ocidburn/4-20-ma-to-pulse-output/hardware/am24_shield_bottom.png

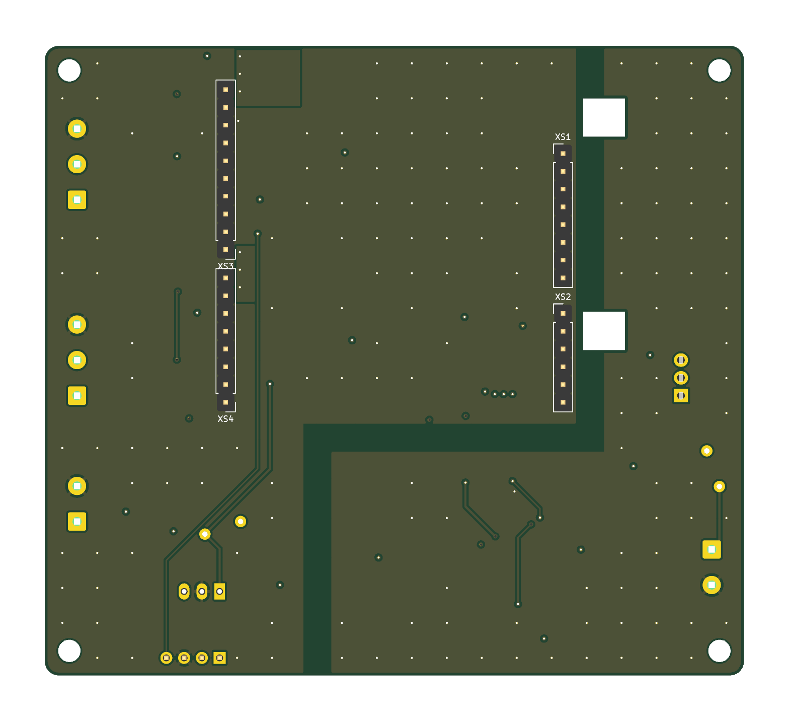
hardware/am24_shield_bottom.png
