ocidburn/4-20-ma-to-pulse-output/hardware/am24_shield_top.png

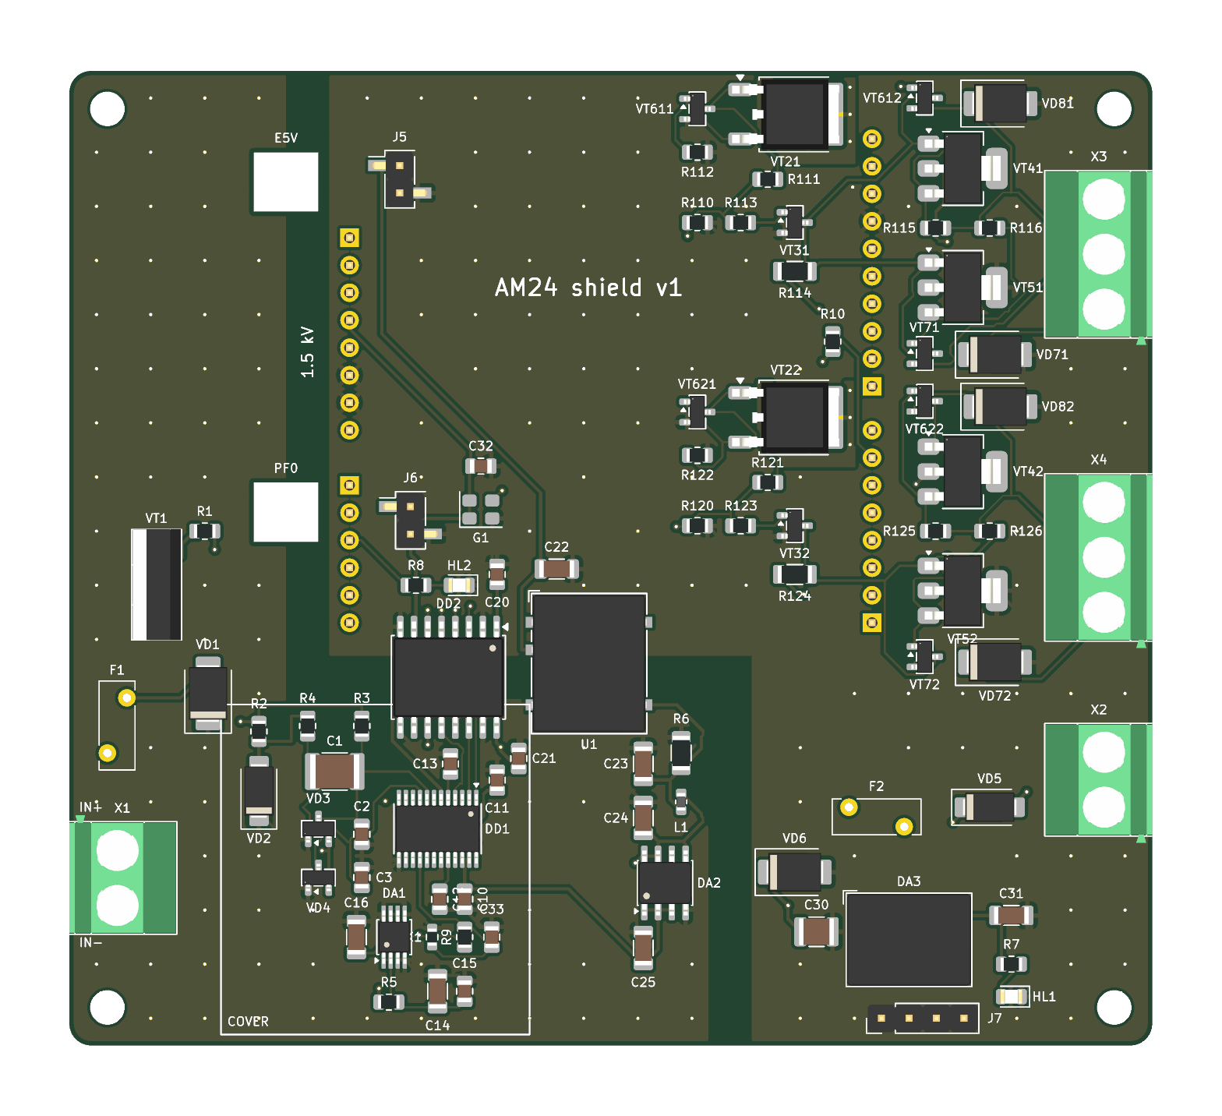
hardware/am24_shield_top.png
