ocidburn/4-20-ma-to-pulse-output/hardware/am24_shield_bom.csv

refs | qty | value | mpn | footprint
C1 | 1 | 0.47u 50V U2J | C1812C474J5JACTU | Capacitor_SMD:C_1812_4532Metric
C2 C3 | 2 | 10n C0G |  | Capacitor_SMD:C_0805_2012Metric
C10 C11 C12 C13 C15 C20 C21 C33 | 8 | 100n |  | Capacitor_SMD:C_0805_2012Metric
C14 C22 C24 C25 C31 | 5 | 10u 16V |  | Capacitor_SMD:C_1206_3216Metric
C16 | 1 | 10u 16V (2.7-100u req.) |  | Capacitor_SMD:C_1206_3216Metric
C23 | 1 | 4.7u 16V |  | Capacitor_SMD:C_1206_3216Metric
C30 | 1 | 10u 50V |  | Capacitor_SMD:C_1210_3225Metric
C32 | 1 | 10n |  | Capacitor_SMD:C_0805_2012Metric
DA1 | 1 | LTC6655BHMS8-3 | LTC6655BHMS8-3#PBF | Package_SO:MSOP-8_3x3mm_P0.65mm
DA2 | 1 | ADP7118ARDZ-3.3 | ADP7118ARDZ-3.3 | Package_SO:SOIC-8-1EP_3.9x4.9mm_P1.27mm_EP2.29x3mm
DA3 | 1 | R-78HB5.0-0.5 | R-78HB5.0-0.5 | Converter_DCDC:Converter_DCDC_RECOM_R-78HB-0.5_THT
DD1 | 1 | AD7124-4BRUZ | AD7124-4BRUZ | Package_SO:TSSOP-24_4.4x7.8mm_P0.65mm
DD2 | 1 | ISO7741DWR | ISO7741DWR | Package_SO:SOIC-16W_7.5x10.3mm_P1.27mm
F1 | 1 | MF-R005-0 50mA | MF-R005-0 | AM24:Fuse_Bourns_MF-R_8.0x3.1mm_P5.10mm
F2 | 1 | MF-R050 0.5A | MF-R050 | AM24:Fuse_Bourns_MF-R_8.0x3.1mm_P5.10mm
G1 | 1 | ASTX-H11-10.000MHZ-T | ASTX-H11-10.000MHZ-T | Oscillator:Oscillator_SMD_Abracon_ASE-4Pin_3.2x2.5mm
HL1 | 1 | LED green |  | LED_SMD:LED_0805_2012Metric
HL2 | 1 | LED red |  | LED_SMD:LED_0805_2012Metric
J5 | 1 | +5V -> E5V (CN7-6) |  | Connector_PinHeader_2.54mm:PinHeader_1x02_P2.54mm_Vertical_SMD_Pin1Left
J6 | 1 | TCXO -> OSC_IN (PF0) |  | Connector_PinHeader_2.54mm:PinHeader_1x02_P2.54mm_Vertical_SMD_Pin1Left
J7 | 1 | GPS PPS: +5V, +3V3, GND, PPS |  | Connector_PinHeader_2.54mm:PinHeader_1x04_P2.54mm_Vertical
L1 | 1 | BLM18KG601SN1D | BLM18KG601SN1D | Inductor_SMD:L_0603_1608Metric
R1 | 1 | 22R (select 15-33R) |  | Resistor_SMD:R_0805_2012Metric
R2 | 1 | 50R Z-foil 0.05% | Y402250R0000A9R | Resistor_SMD:R_0805_2012Metric
R3 R4 | 2 | 1k 0.1% 25ppm | ERA-6AEB102V | Resistor_SMD:R_0805_2012Metric
R6 | 1 | 270R 0.25W ballast |  | Resistor_SMD:R_1206_3216Metric
R8 | 1 | 330R |  | Resistor_SMD:R_0805_2012Metric
R9 | 1 | 10k 0.1% 25ppm | ERA-6AEB103V | Resistor_SMD:R_0805_2012Metric
R10 | 1 | 100R |  | Resistor_SMD:R_0805_2012Metric
R110 R120 | 2 | 10k |  | Resistor_SMD:R_0805_2012Metric
R111 R113 R121 R123 R7 | 5 | 1k |  | Resistor_SMD:R_0805_2012Metric
R112 R115 R116 R122 R125 R126 R5 | 7 | 10R |  | Resistor_SMD:R_0805_2012Metric
R114 R124 | 2 | 4k7 0.25W |  | Resistor_SMD:R_1206_3216Metric
RK1 | 1 | NTC 10k 1% B25/50 3380K | NCU18XH103F60RB | Resistor_SMD:R_0603_1608Metric
U1 | 1 | NXE1S0505MC-R7 | NXE1S0505MC-R7 | Converter_DCDC:Converter_DCDC_Murata_NXExSxxxxMC_SMD
VD1 | 1 | SMBJ33CA | SMBJ33CA-13-F | Diode_SMD:D_SMB
VD2 | 1 | S1M | S1M | Diode_SMD:D_SMA
VD3 VD4 | 2 | BAV199 | BAV199,215 | Package_TO_SOT_SMD:SOT-23
VD5 | 1 | SS110 | SS110 | Diode_SMD:D_SMA
VD6 VD71 VD72 VD81 VD82 | 5 | SMBJ33A | SMBJ33ATR | Diode_SMD:D_SMB
VT1 | 1 | DN2540N5-G | DN2540N5-G | Package_TO_SOT_THT:TO-220-3_Vertical
VT21 VT22 | 2 | NTD3055L104T4G | NTD3055L104T4G | Package_TO_SOT_SMD:TO-252-2
VT31 VT32 VT611 VT612 VT621 VT622 | 6 | BC847B | BC847B,215 | Package_TO_SOT_SMD:SOT-23
VT41 VT42 | 2 | BCP56-16 | BCP56-16T1G | Package_TO_SOT_SMD:SOT-223-3_TabPin2
VT51 VT52 | 2 | BCP53-16 | BCP5316QTA | Package_TO_SOT_SMD:SOT-223-3_TabPin2
VT71 VT72 | 2 | BC857B | BC857B,215 | Package_TO_SOT_SMD:SOT-23
X1 | 1 | IN 4-20 mA |  | TerminalBlock_Phoenix:TerminalBlock_Phoenix_MKDS-1,5-2-5.08_1x02_P5.08mm_Horizontal
X2 | 1 | 24V DC |  | TerminalBlock_Phoenix:TerminalBlock_Phoenix_MKDS-1,5-2-5.08_1x02_P5.08mm_Horizontal
X3 | 1 | OUT1 PP/OC/0V |  | TerminalBlock_Phoenix:TerminalBlock_Phoenix_MKDS-1,5-3-5.08_1x03_P5.08mm_Horizontal
X4 | 1 | OUT2 PP/OC/0V |  | TerminalBlock_Phoenix:TerminalBlock_Phoenix_MKDS-1,5-3-5.08_1x03_P5.08mm_Horizontal
XS1 | 1 | Arduino POWER |  | Connector_PinHeader_2.54mm:PinHeader_1x08_P2.54mm_Vertical
XS2 | 1 | Arduino A0-A5 |  | Connector_PinHeader_2.54mm:PinHeader_1x06_P2.54mm_Vertical
XS3 | 1 | Arduino D8-D15 |  | Connector_PinHeader_2.54mm:PinHeader_1x10_P2.54mm_Vertical
XS4 | 1 | Arduino D0-D7 |  | Connector_PinHeader_2.54mm:PinHeader_1x08_P2.54mm_Vertical
