ocidburn/4-20-ma-to-pulse-output/hardware/am24_shield.pdf

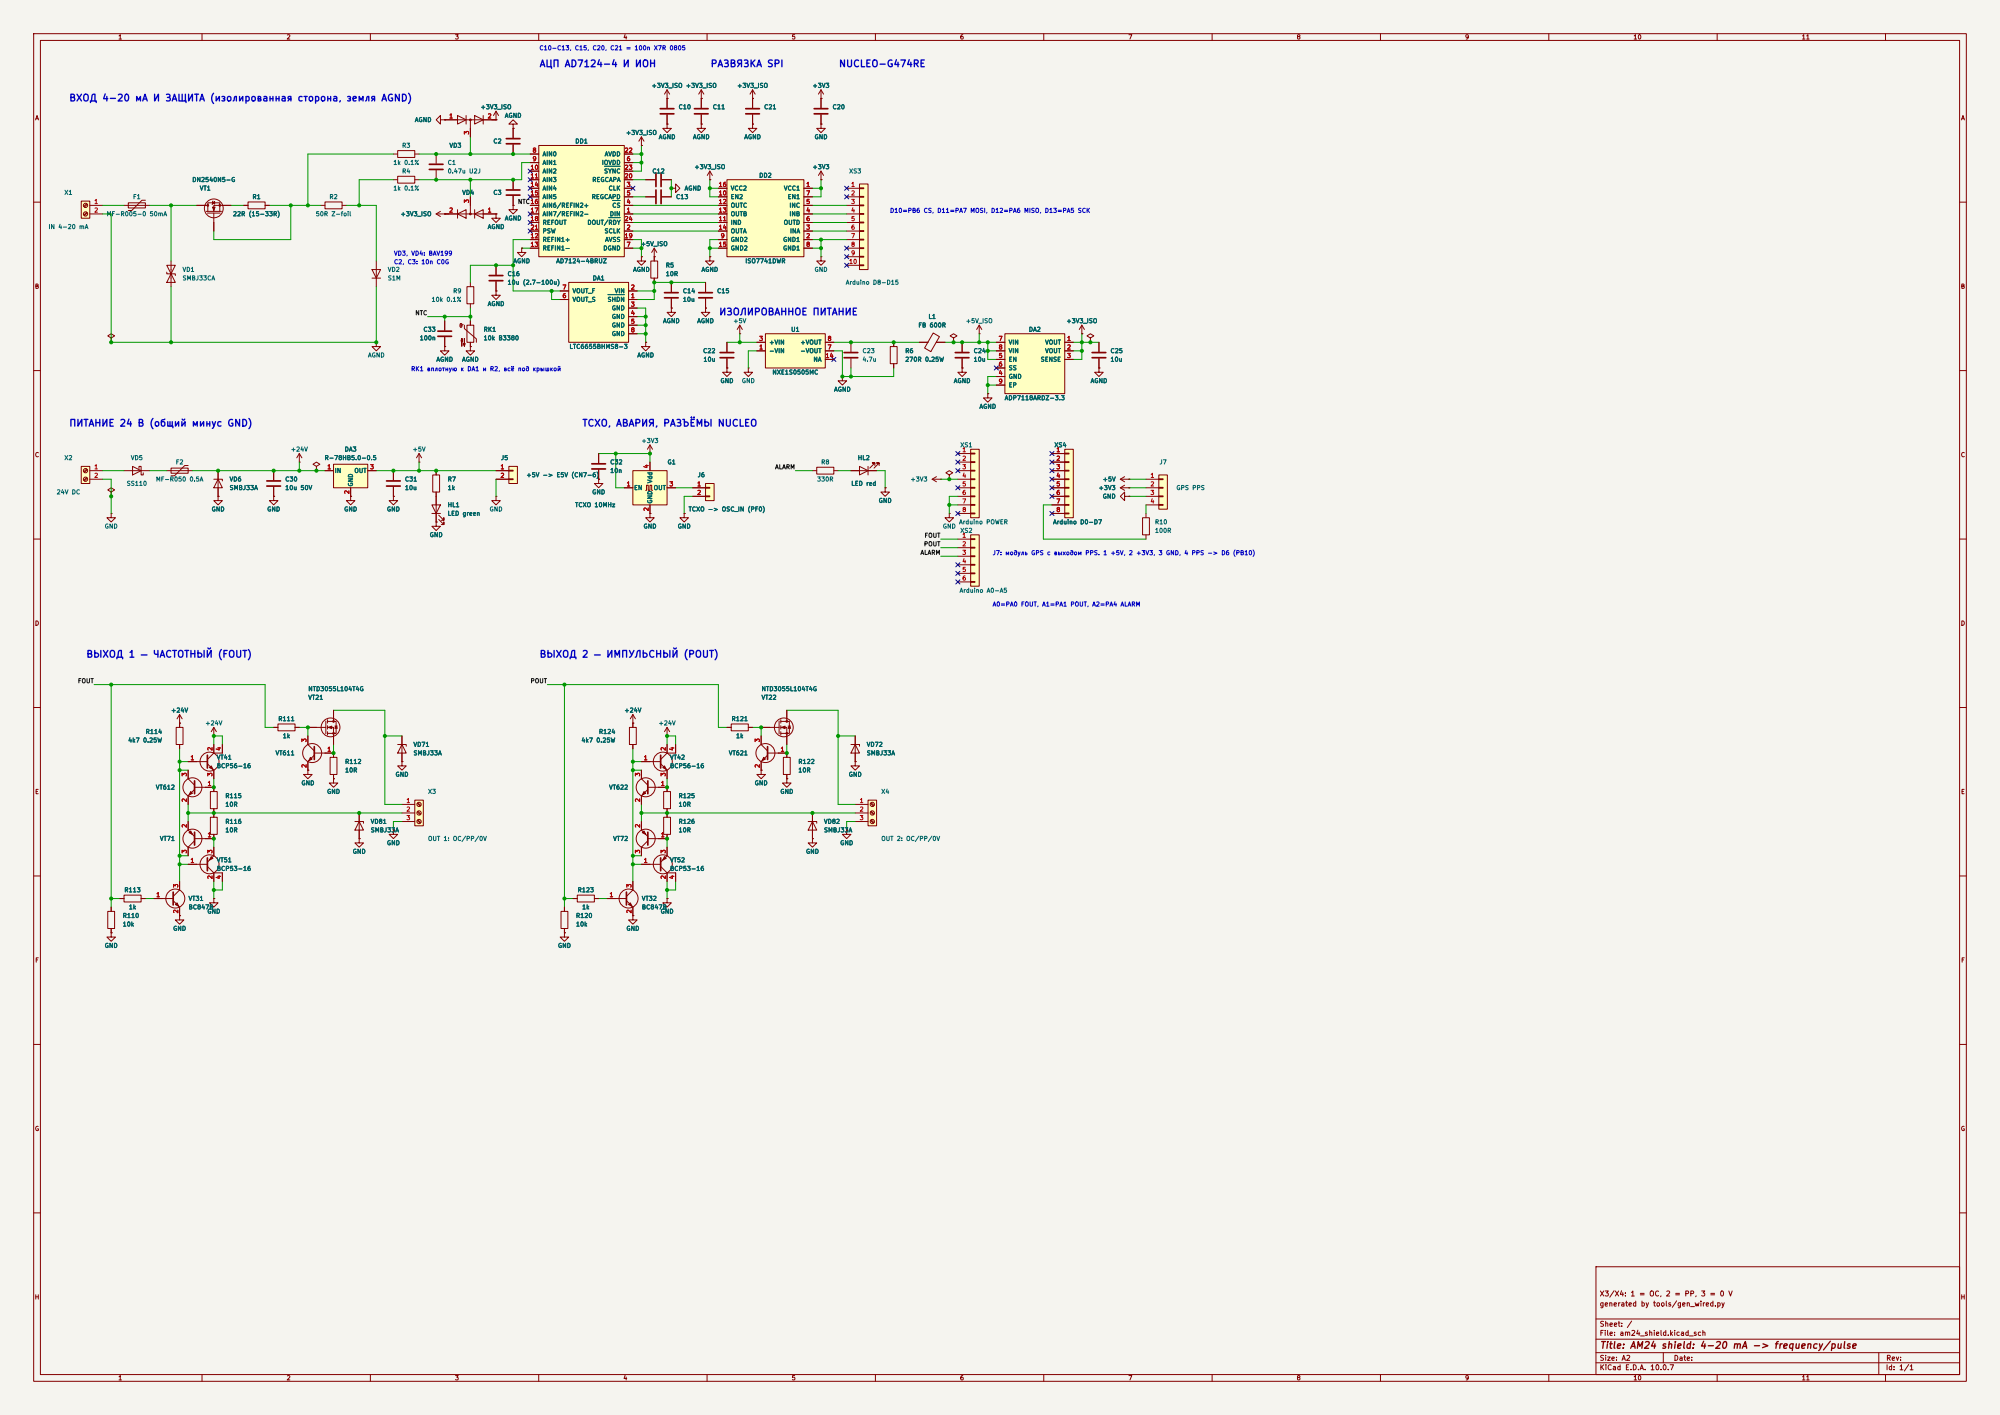
[picture p5: page 1]

ВХОД 4-20 мА И ЗАЩИТА (изолированная сторона, земля AGND)

AIN1 9

C2, C3: 10n C0G ПИТАНИЕ 24 В (общий минус GND)

J7: модуль GPS с выходом PPS. 1 +5V, 2 +3V3, 3 GND, 4 PPS -> D6 (PB10) RK1 вплотную к DA1 и R2, всё под крышкой

TCXO, АВАРИЯ, РАЗЪЁМЫ NUCLEO

generated by tools/gen_wired.py

Sheet: /
File: am24_shield.kicad_sch
Title: AM24 shield: 4-20 mA -> frequency/pulse

Size: A2 | Rev:
KiCad E.D.A. 10.0.7 | Id: 1/1
