ocidburn/4-20-ma-to-pulse-output/hardware/am24_shield_assembly_top.pdf

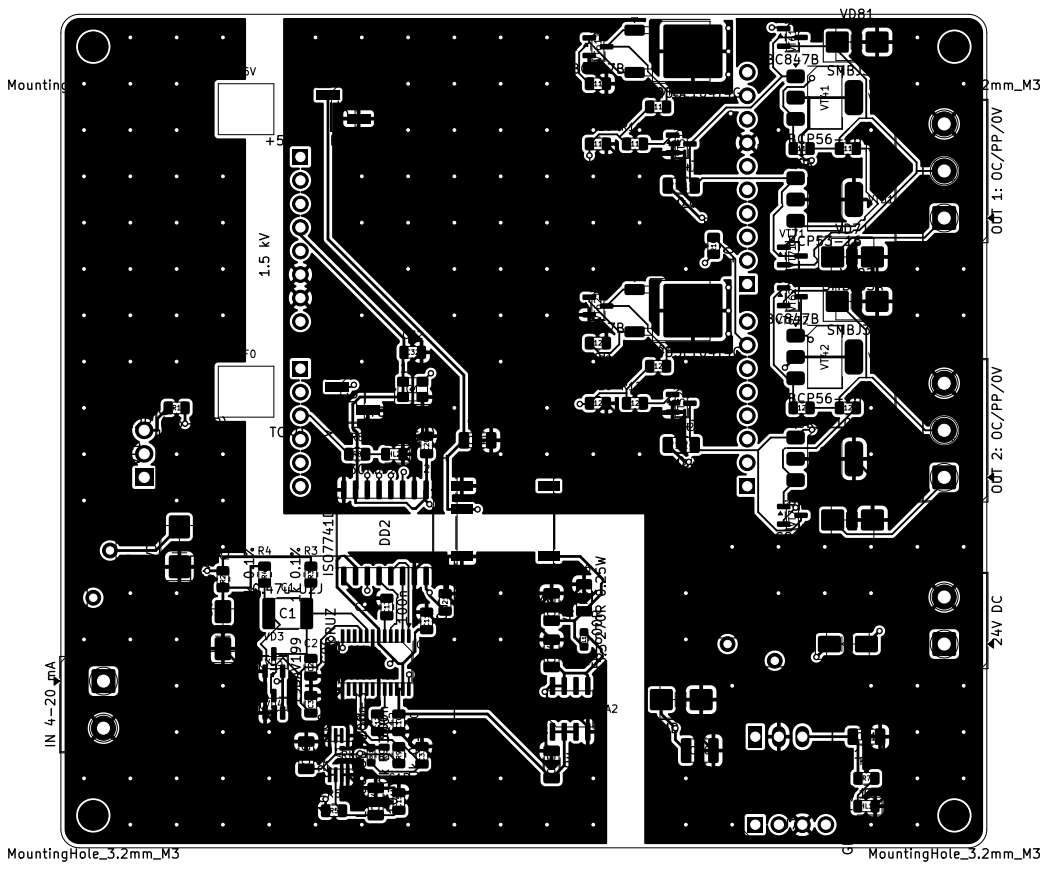
[picture p6: page 1]
