ocidburn/4-20-ma-to-pulse-output/hardware/am24_shield.kicad_pcb

## KiCad design hardware/am24_shield.kicad_pcb (2026-10-24)

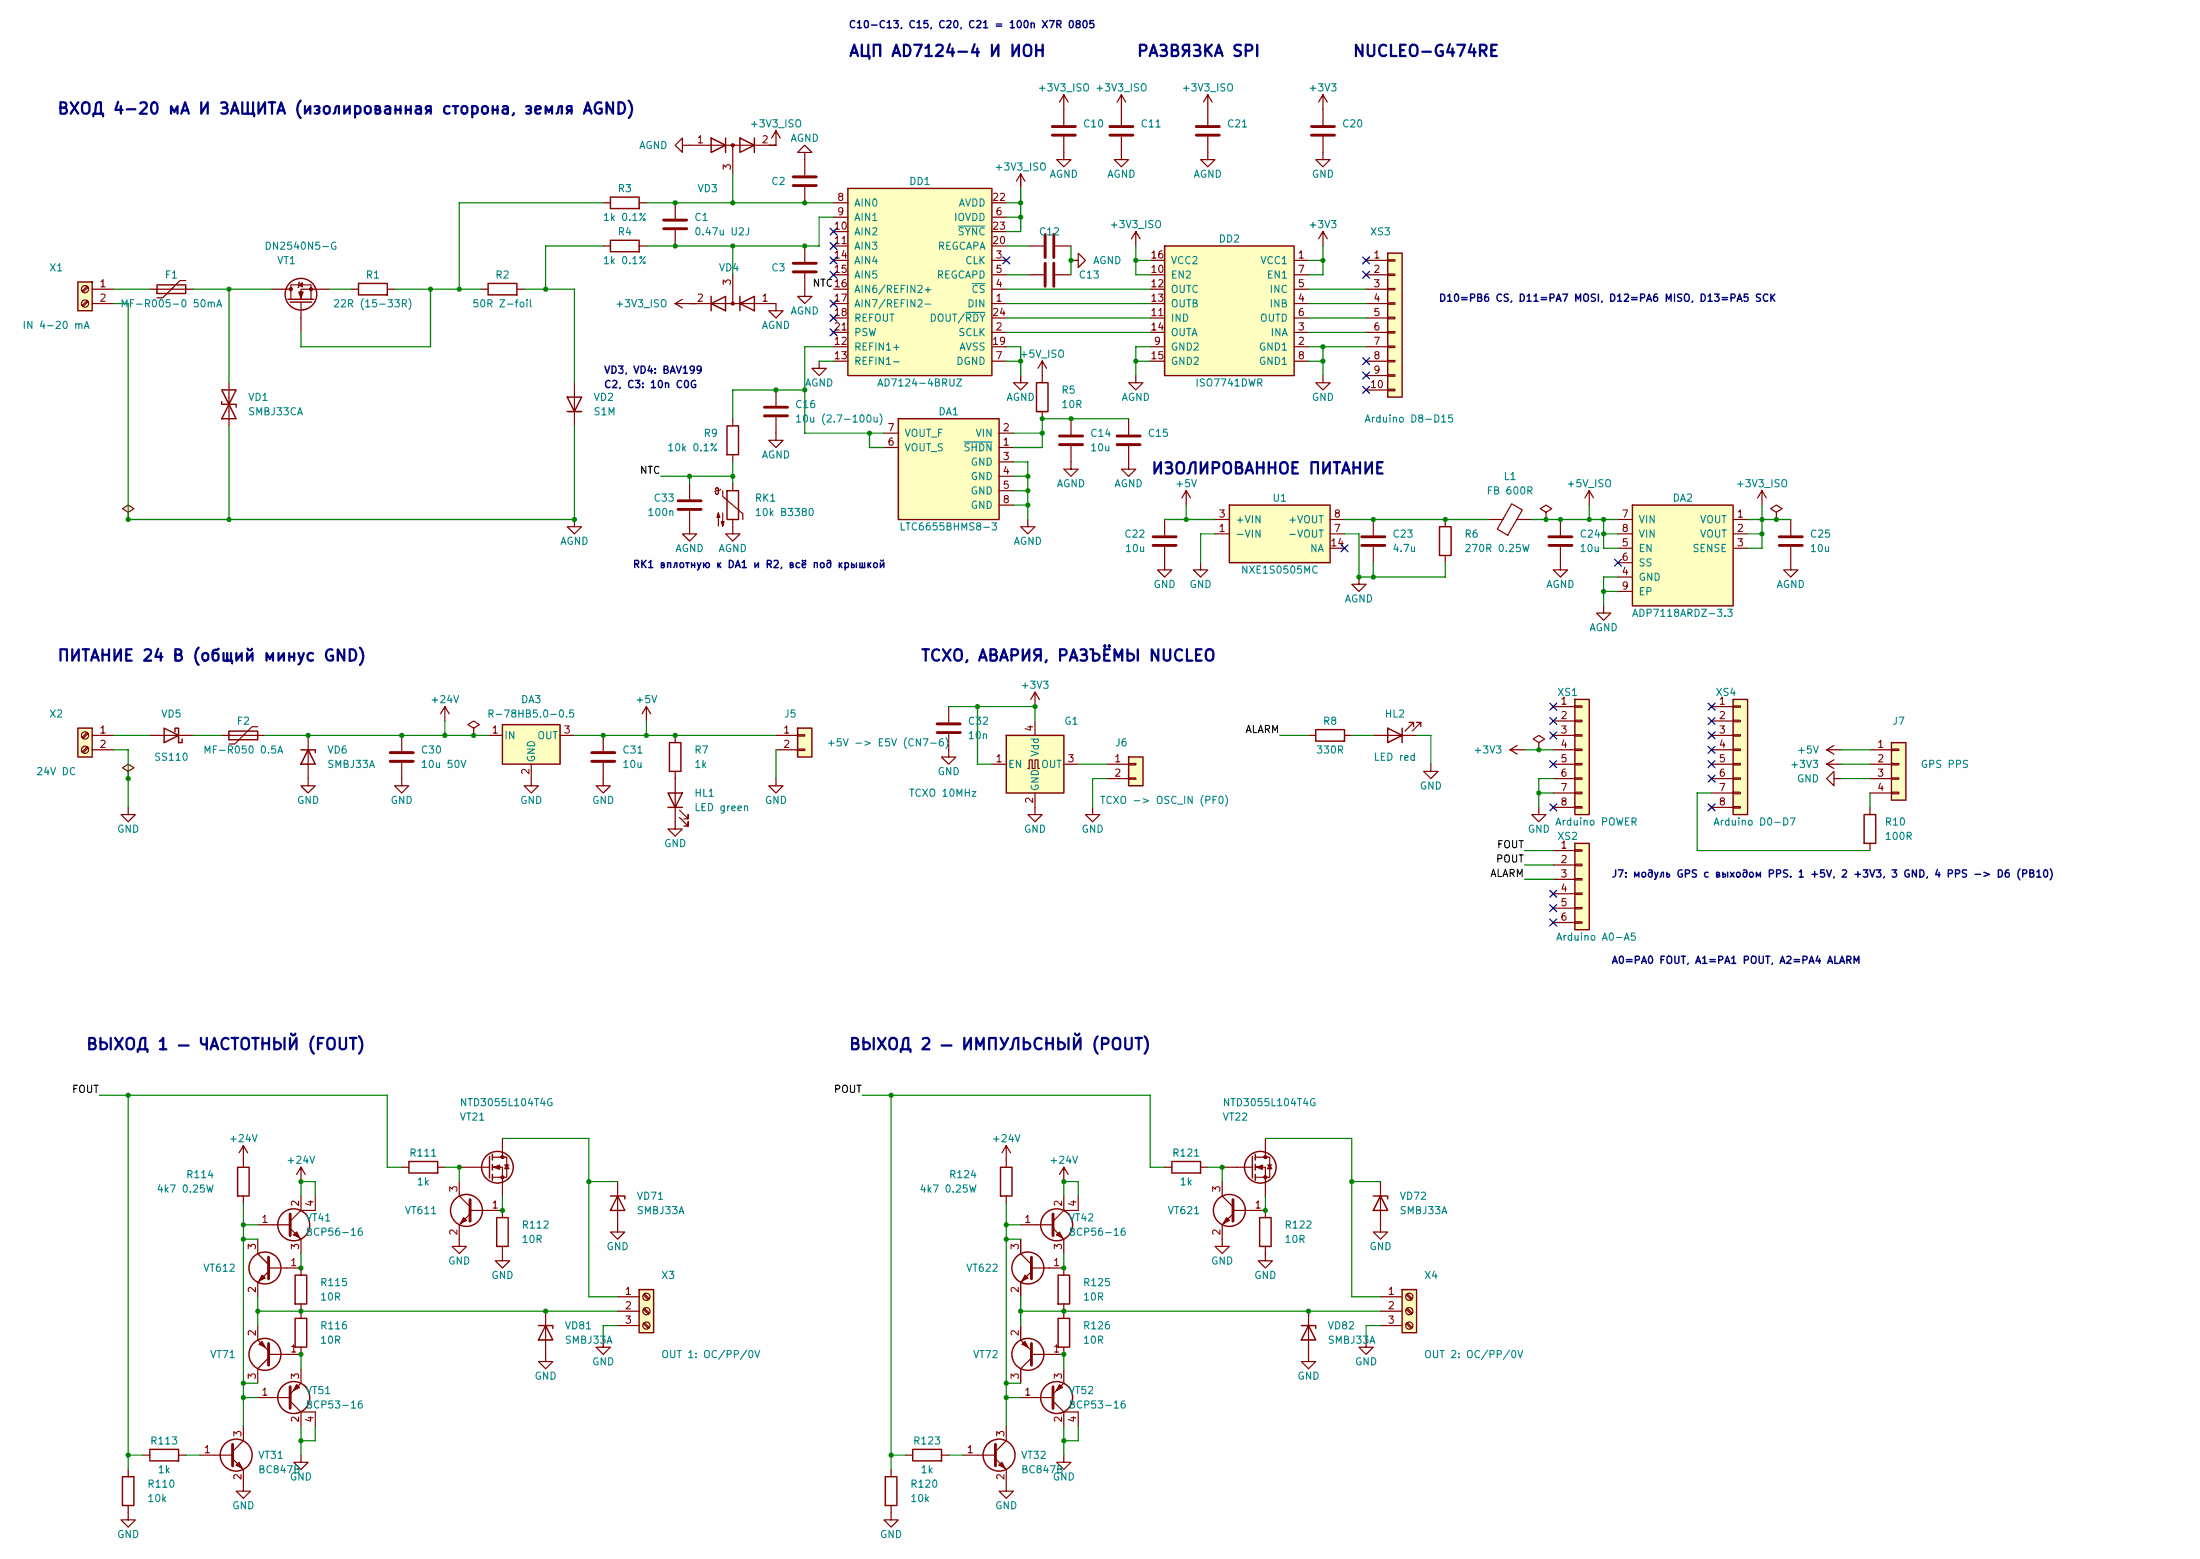
[picture p7: schematic am24_shield.kicad_sch, AM24 shield: 4-20 mA -> frequency/pulse]

Parts:
C1: 0.47u U2J; C_1812_4532Metric; MPN C1812C474J5JACTU
C2, C3: 10n C0G; C_0805_2012Metric
C10, C11, C12, C13, C15, C20, C21, C33: 100n; C_0805_2012Metric
C14, C22, C24, C25, C31: 10u; C_1206_3216Metric
C16: 10u (2.7-100u); C_1206_3216Metric
C23: 4.7u; C_1206_3216Metric
C30: 10u 50V; C_1210_3225Metric
C32: 10n; C_0805_2012Metric
DA1: LTC6655BHMS8-3; MSOP-8_3x3mm_P0.65mm; MPN LTC6655BHMS8-3#PBF
DA2: ADP7118ARDZ-3.3; SOIC-8-1EP_3.9x4.9mm_P1.27mm_EP2.29x3mm; MPN ADP7118ARDZ-3.3
DA3: R-78HB5.0-0.5; Converter_DCDC_RECOM_R-78HB-0.5_THT; MPN R-78HB5.0-0.5
DD1: AD7124-4BRUZ; TSSOP-24_4.4x7.8mm_P0.65mm; MPN AD7124-4BRUZ
DD2: ISO7741DWR; SOIC-16W_7.5x10.3mm_P1.27mm; MPN ISO7741DWR
F1: MF-R005-0 50mA; Fuse_Bourns_MF-R_8.0x3.1mm_P5.10mm; MPN MF-R005-0
F2: MF-R050 0.5A; Fuse_Bourns_MF-R_8.0x3.1mm_P5.10mm; MPN MF-R050
G1: TCXO 10MHz; Oscillator_SMD_Abracon_ASE-4Pin_3.2x2.5mm; MPN ASTX-H11-10.000MHZ-T
HL1: LED green; LED_0805_2012Metric
HL2: LED red; LED_0805_2012Metric
J5: +5V -> E5V (CN7-6); PinHeader_1x02_P2.54mm_Vertical_SMD_Pin1Left
J6: TCXO -> OSC_IN (PF0); PinHeader_1x02_P2.54mm_Vertical_SMD_Pin1Left
J7: GPS PPS; PinHeader_1x04_P2.54mm_Vertical
L1: FB 600R; L_0603_1608Metric; MPN BLM18KG601SN1D
R1: 22R (15-33R); R_0805_2012Metric
R2: 50R Z-foil; R_0805_2012Metric; MPN Y402250R0000A9R
R3, R4: 1k 0.1%; R_0805_2012Metric; MPN ERA-6AEB102V
R5, R112, R115, R116, R122, R125, R126: 10R; R_0805_2012Metric
R6: 270R 0.25W; R_1206_3216Metric
R7, R111, R113, R121, R123: 1k; R_0805_2012Metric
R8: 330R; R_0805_2012Metric
R9: 10k 0.1%; R_0805_2012Metric; MPN ERA-6AEB103V
R10: 100R; R_0805_2012Metric
R110, R120: 10k; R_0805_2012Metric
R114, R124: 4k7 0.25W; R_1206_3216Metric
RK1: 10k B3380; R_0603_1608Metric; MPN NCU18XH103F60RB
U1: NXE1S0505MC; Converter_DCDC_Murata_NXExSxxxxMC_SMD; MPN NXE1S0505MC-R7
VD1: SMBJ33CA; D_SMB; MPN SMBJ33CA-13-F
VD2: S1M; D_SMA; MPN S1M
VD3, VD4: BAV199; SOT-23; MPN BAV199,215
VD5: SS110; D_SMA; MPN SS110
VD6, VD71, VD72, VD81, VD82: SMBJ33A; D_SMB; MPN SMBJ33ATR
VT1: DN2540N5-G; TO-220-3_Vertical; MPN DN2540N5-G
VT21, VT22: NTD3055L104T4G; TO-252-2; MPN NTD3055L104T4G
VT31, VT32, VT611, VT612, VT621, VT622: BC847B; SOT-23; MPN BC847B,215
VT41, VT42: BCP56-16; SOT-223-3_TabPin2; MPN BCP56-16T1G
VT51, VT52: BCP53-16; SOT-223-3_TabPin2; MPN BCP5316QTA
VT71, VT72: BC857B; SOT-23; MPN BC857B,215
X1: IN 4-20 mA; TerminalBlock_Phoenix_MKDS-1,5-2-5.08_1x02_P5.08mm_Horizont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
X2: 24V DC; TerminalBlock_Phoenix_MKDS-1,5-2-5.08_1x02_P5.08mm_Horizont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
X3: OUT 1: OC/PP/0V; TerminalBlock_Phoenix_MKDS-1,5-3-5.08_1x03_P5.08mm_Horizont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
X4: OUT 2: OC/PP/0V; TerminalBlock_Phoenix_MKDS-1,5-3-5.08_1x03_P5.08mm_Horizont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
XS1: Arduino POWER; PinHeader_1x08_P2.54mm_Vertical
XS2: Arduino A0-A5; PinHeader_1x06_P2.54mm_Vertical
XS3: Arduino D8-D15; PinHeader_1x10_P2.54mm_Vertical
XS4: Arduino D0-D7; PinHeader_1x08_P2.54mm_Vertical

Connections:
+3V3: C20.1, C32.1, DD2.1 (VCC1), DD2.7 (EN1), G1.1 (EN), G1.4 (Vdd), J7.2, XS1.4
+3V3_ISO: C10.1, C11.1, C21.1, C25.1, DA2.1 (VOUT), DA2.2 (VOUT), DA2.3 (SENSE), DD1.6 (IOVDD), DD1.22 (AVDD), DD1.23 (~SYNC), DD2.10 (EN2), DD2.16 (VCC2), VD3.2 (K), VD4.2 (K)
+5V: C22.1, C31.1, DA3.3 (OUT), J5.1, J7.1, R7.1, U1.3 (+VIN)
+5V_ISO: C24.1, DA2.5 (EN), DA2.7 (VIN), DA2.8 (VIN), L1.2, R5.1
+24V: C30.1, DA3.1 (IN), F2.2, R114.1, R124.1, VD6.1 (K), VT41.2 (C), VT41.4 (C), VT42.2 (C), VT42.4 (C)
/ALARM: R8.1, XS2.3
/FOUT: R110.1, R111.1, R113.1, XS2.1
/NTC: C33.1, DD1.16 (AIN6/REFIN2+), R9.2, RK1.1
/POUT: R120.1, R121.1, R123.1, XS2.2
AGND: C2.1, C3.2, C10.2, C11.2, C12.2, C13.2, C14.2, C15.2, C16.2, C21.2, C23.2, C24.2, C25.2, C33.2, DA1.3 (GND), DA1.4 (GND), DA1.5 (GND), DA1.8 (GND), DA2.4 (GND), DA2.9 (EP), DD1.7 (DGND), DD1.13 (REFIN1-), DD1.19 (AVSS), DD2.9 (GND2), DD2.15 (GND2), R6.2, RK1.2, U1.7 (-VOUT), VD1.1 (A1), VD2.1 (K), VD3.1 (A), VD4.1 (A), X1.2
GND: C20.2, C22.2, C30.2, C31.2, C32.2, DA3.2 (GND), DD2.2 (GND1), DD2.8 (GND1), G1.2 (GND), HL1.1 (K), HL2.1 (K), J5.2, J6.2, J7.3, R110.2, R112.2, R120.2, R122.2, U1.1 (-VIN), VD6.2 (A), VD71.2 (A), VD72.2 (A), VD81.2 (A), VD82.2 (A), VT31.2 (E), VT32.2 (E), VT51.2 (C), VT51.4 (C), VT52.2 (C), VT52.4 (C), VT611.2 (E), VT621.2 (E), X2.2, X3.3, X4.3, XS1.6, XS1.7, XS3.7
unnamed: C14.1, C15.1, DA1.1 (~SHDN), DA1.2 (VIN), R5.2
unnamed: C16.1, DA1.6 (VOUT_S), DA1.7 (VOUT_F), DD1.12 (REFIN1+), R9.1
unnamed: C1.1, C2.2, DD1.8 (AIN0), R3.2, VD3.3 (common)
unnamed: C1.2, C3.1, DD1.9 (AIN1), R4.2, VD4.3 (common)
unnamed: DD1.1 (DIN), DD2.13 (OUTB)
unnamed: DD1.24 (DOUT/~RDY), DD2.11 (IND)
unnamed: C12.1, DD1.20 (REGCAPA)
unnamed: C13.1, DD1.5 (REGCAPD)
unnamed: DD1.2 (SCLK), DD2.14 (OUTA)
unnamed: DD1.4 (~CS), DD2.12 (OUTC)
unnamed: DD2.3 (INA), XS3.6
unnamed: DD2.4 (INB), XS3.4
unnamed: DD2.5 (INC), XS3.3
unnamed: DD2.6 (OUTD), XS3.5
unnamed: G1.3 (OUT), J6.1
unnamed: HL1.2 (A), R7.2
unnamed: HL2.2 (A), R8.2
unnamed: J7.4, R10.1
unnamed: C23.1, L1.1, R6.1, U1.8 (+VOUT)
unnamed: F1.2, VD1.2 (A2), VT1.2 (D)
unnamed: R2.2, R4.1, VD2.2 (A)
unnamed: VD5.2 (A), X2.1
unnamed: F2.1, VD5.1 (K)
unnamed: VD71.1 (K), VT21.2 (D), X3.1
unnamed: VD72.1 (K), VT22.2 (D), X4.1
unnamed: R115.2, R116.1, VD81.1 (K), VT71.2 (E), VT612.2 (E), X3.2
unnamed: R125.2, R126.1, VD82.1 (K), VT72.2 (E), VT622.2 (E), X4.2
unnamed: R1.2, R2.1, R3.1, VT1.1 (G)
unnamed: R1.1, VT1.3 (S)
unnamed: R111.2, VT21.1 (G), VT611.3 (C)
unnamed: R112.1, VT21.3 (S), VT611.1 (B)
unnamed: R121.2, VT22.1 (G), VT621.3 (C)
unnamed: R122.1, VT22.3 (S), VT621.1 (B)
unnamed: R113.2, VT31.1 (B)
unnamed: R114.2, VT31.3 (C), VT41.1 (B), VT51.1 (B), VT71.3 (C), VT612.3 (C)
unnamed: R123.2, VT32.1 (B)
unnamed: R124.2, VT32.3 (C), VT42.1 (B), VT52.1 (B), VT72.3 (C), VT622.3 (C)
unnamed: R115.1, VT41.3 (E), VT612.1 (B)
unnamed: R125.1, VT42.3 (E), VT622.1 (B)
unnamed: R116.2, VT51.3 (E), VT71.1 (B)
unnamed: R126.2, VT52.3 (E), VT72.1 (B)
unnamed: F1.1, X1.1
unnamed: R10.2, XS4.7

Notes on the sheet:
ВХОД 4-20 мА И ЗАЩИТА (изолированная сторона, земля AGND)
VD3, VD4: BAV199
C2, C3: 10n C0G
АЦП AD7124-4 И ИОН
RK1 вплотную к DA1 и R2, всё под крышкой
РАЗВЯЗКА SPI
NUCLEO-G474RE
D10=PB6 CS, D11=PA7 MOSI, D12=PA6 MISO, D13=PA5 SCK
C10-C13, C15, C20, C21 = 100n X7R 0805
ИЗОЛИРОВАННОЕ ПИТАНИЕ
ПИТАНИЕ 24 В (общий минус GND)
TCXO, АВАРИЯ, РАЗЪЁМЫ NUCLEO
A0=PA0 FOUT, A1=PA1 POUT, A2=PA4 ALARM
J7: модуль GPS с выходом PPS. 1 +5V, 2 +3V3, 3 GND, 4 PPS -> D6 (PB10)
ВЫХОД 1 — ЧАСТОТНЫЙ (FOUT)
ВЫХОД 2 — ИМПУЛЬСНЫЙ (POUT)

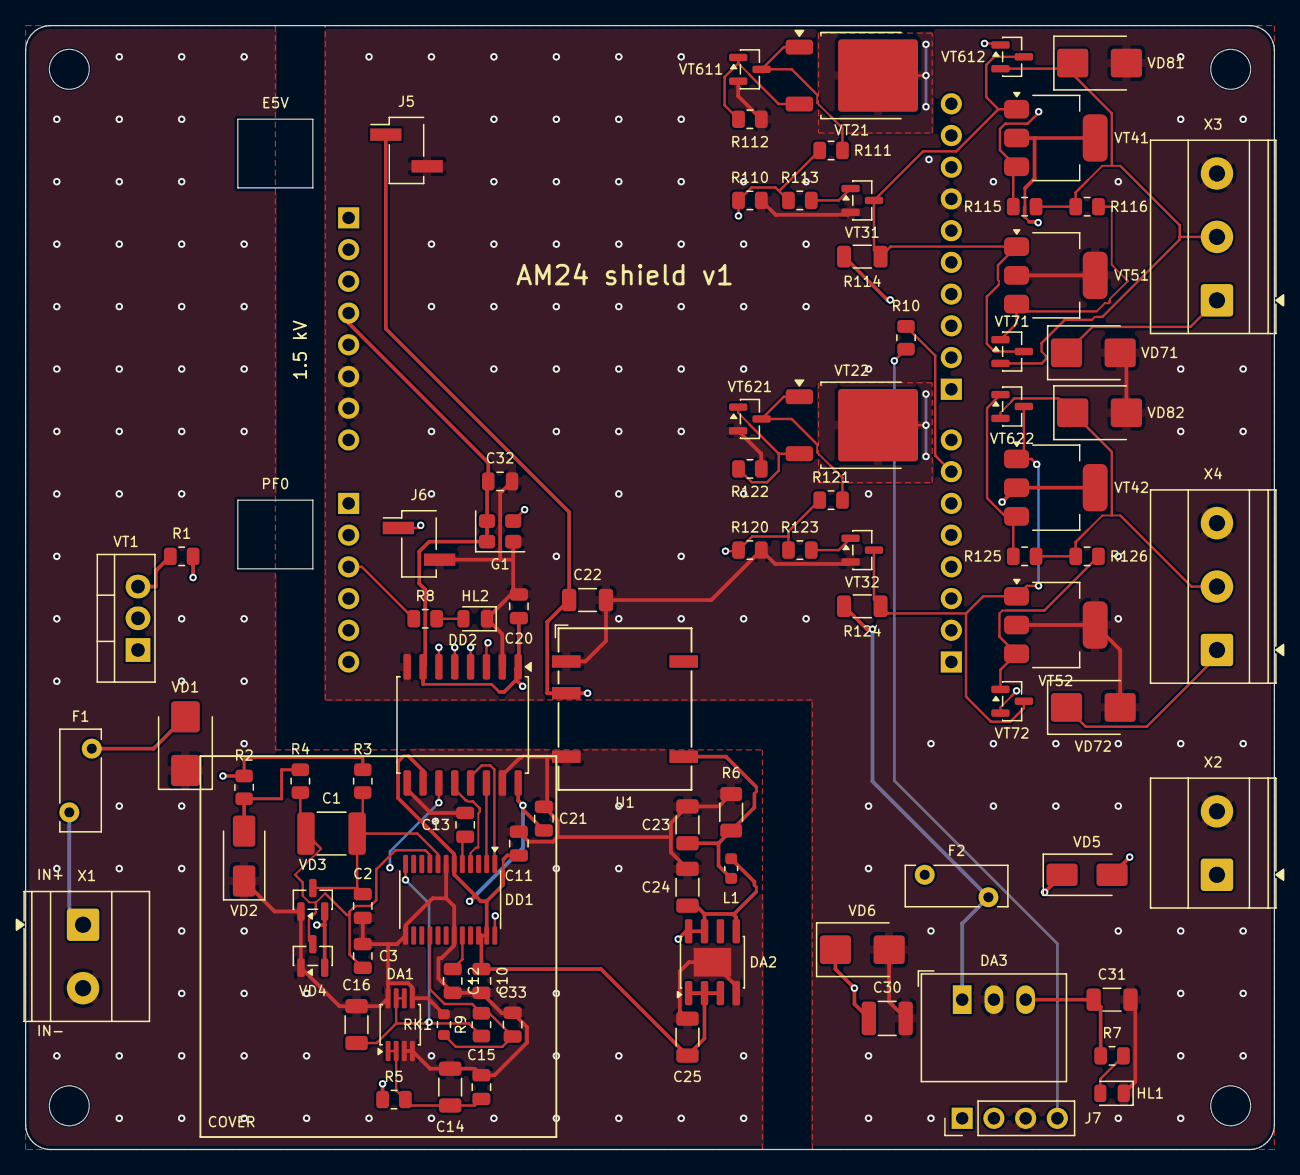
[picture p8: board am24_shield.kicad_pcb from above]

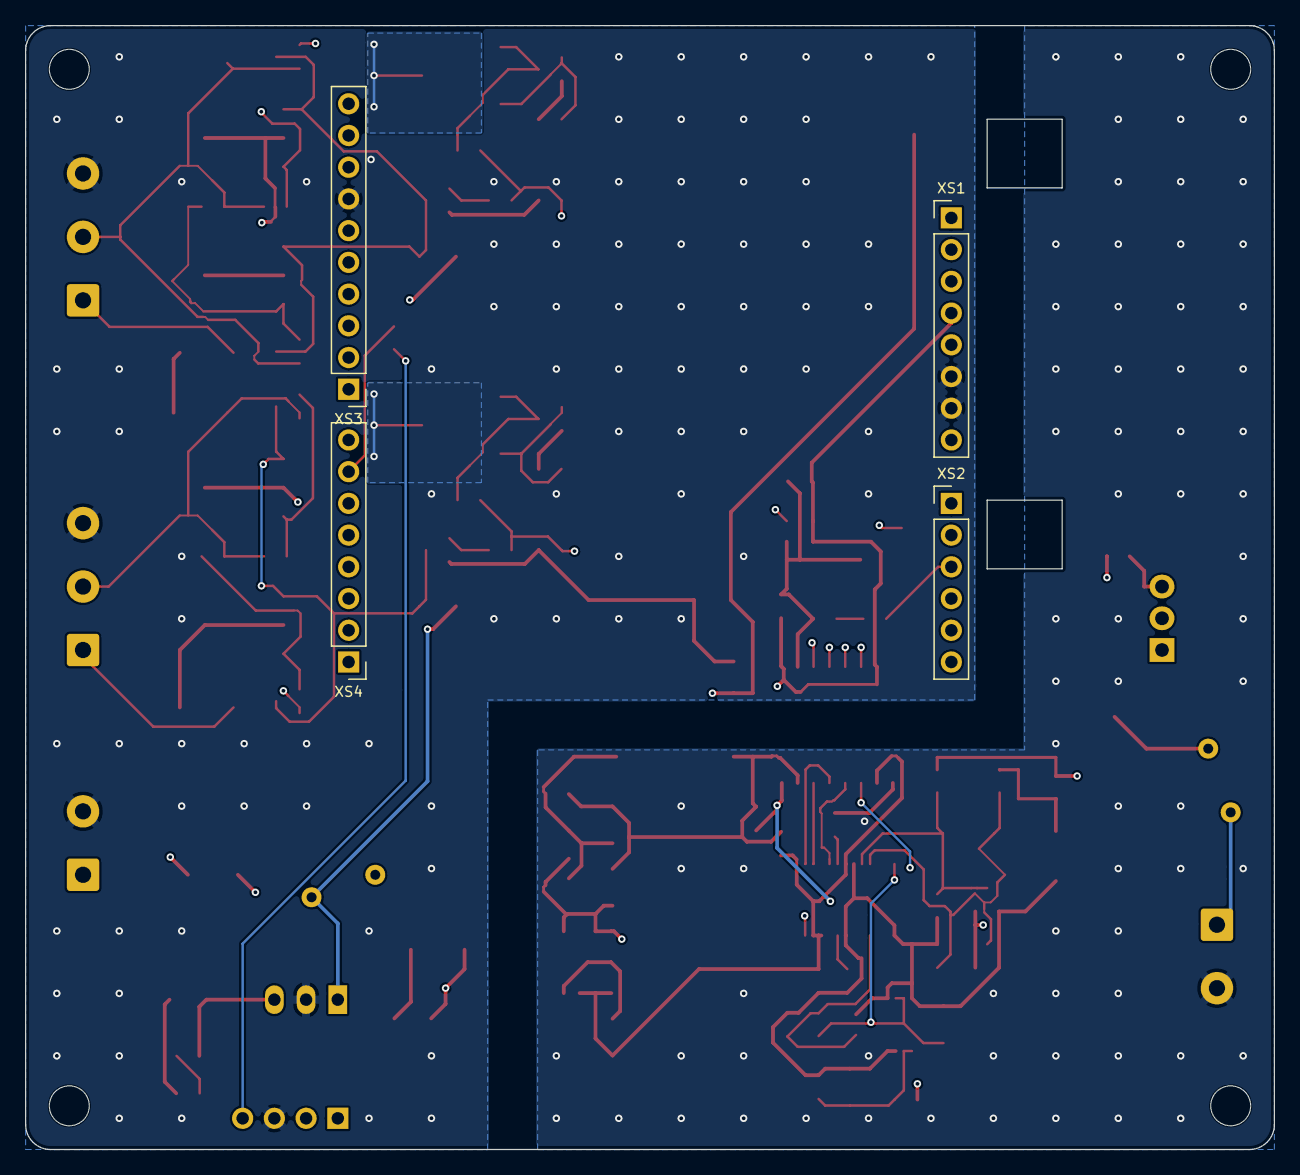
[picture p9: board am24_shield.kicad_pcb from below]

Board: 4 copper layers, 100.0 x 90.0 mm, 97 parts (4 on the bottom side), 54 nets.

Other parts of the board:
H1, H2, H3, H4: MountingHole_3.2mm_M3
