ocidburn/4-20-ma-to-pulse-output/(commit log)

2026-10-23 AM24: 4-20 mA to frequency/pulse converter prototype
    - firmware: STM32G474 (NUCLEO-G474RE), AD7124-4 over ISO7741, 32.32 NCO
    frequency output 0-10 kHz, volume pulse output, USB CLI, flash config
    - hardware: KiCad 10 shield schematic with wired connections, PDF, BOM,
    netlists; X3/X4 terminals 1 = OC, 2 = PP 24 V, 3 = 0 V
    - tools: am24.py PC utility (setup, calibration, verify, log, simulator),
    schematic generators and netlist compare
    - docs: specification, error budget, schematic notes, BOM, calibration
    - CMSIS core and G4 device headers as submodules
    [am24_shield.kicad_sch, am24_shield_bom.csv]
2026-10-23 0.001 % pulse output: chopped ADC, NTC compensation, GPS clock
    - firmware 0.2.0: AIN0/AIN1 swapped pairs cancel ADC offset; NTC on
    AIN6 with per-unit tc_ppm; up to 11 calibration points in double;
    WIN START / WIN? averaging window; GPS PPS on D6 (PB10, TIM2_CH3)
    measures the TCXO and latches the exact pulse total on each edge;
    frequency output moved to TIM5 (same pin PA0); clock correction now
    also applies to the pulse integrator (was frequency output only);
    settings format v2
    - hardware: RK1/R9/C33 NTC divider from VREF, J7 GPS connector + R10
    to D6; BOM updated
    - tools/am24.py: multimeter over VISA (SCPI or 3458A) or manual entry,
    cal (9 points), verify (+-10 ppm), tempco,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
    [am24_shield.kicad_sch, am24_shield_bom.csv]
2026-10-23 Footprint for F1/F2: Bourns MF-R radial PTC
    - hardware/am24.pretty: Fuse_Bourns_MF-R_8.0x3.1mm_P5.10mm, drawn from
    the Bourns MF-R datasheet (pitch 5.1 mm, leads ~1.8 mm apart across
    the 3.1 mm body, 0.8 mm drill for 0.405-0.51 mm leads)
    - hardware/fp-lib-table: project library AM24
    - F1 (MF-R005-0) and F2 (MF-R050) use it; BOM and README updated
    [am24_shield.kicad_sch, am24_shield_bom.csv]
2026-10-24 PCB: 100 x 90 mm shield, 4-layer and 2-layer variants
    - tools/gen_pcb.py: outline with slots over Morpho CN7 pins 29/6,
    placement in the Nucleo-64 frame (Arduino headers on the bottom,
    through-hole parts only off the Nucleo), 4 mm copper-free isolation
    barrier crossed only by ISO7741 and NXE1, net classes, hand-routed
    Kelvin lines from the shunt, In1 AGND/GND plane on 4 layers
    - tools/route_pcb.py: Freerouting (headless), ground pours, drain
    copper under the OC DPAKs, stitching vias, dead-end cleanup
    - tools/export_fab.py: Gerber, drill and position files per board
    - hardware: both boards, fab zips, renders, top assembly drawing;
    J5/J6 changed to SMD pin headers
    - DRC: no unconne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
    [am24_shield.kicad_pcb, am24_shield.kicad_sch, am24_shield_2layer.kicad_pcb, am24_shield_bom.csv]
